CecchiLinux/arduino-guitar-trainer/README.md

# arduino-guitar-trainer

Progetto per il corso di Laboratorio di Making, anno 2017/2018. [Documentazione](./DOC.md).

L'Arduino-Guitar-Trainer è uno strumento hardware che aggiunge al classico metronomo alcune funzionalità pensate per il chitarrista principiante. Grazie alla trasposizione hardware del manico della chitarra, l'AGT guida il principiante nell'esecuzione dei classici esercizi di riscaldamento e di sviluppo dell'orecchio ritmico e della tecnica ritmica.

Lo strumento contiene i principali: accordi, giri armonici e scale. Il chitarrista potrà visualizzare questi elementi musicali nel manico di chitarra presente nello strumento, in modo da studiarli o ripassarli e poi decidere di suonarli azionando il meronomo. E' possibile selezionare bpm e numero di movimenti per battuta.
