CecchiLinux/arduino-guitar-trainer/imgs/05-fronte_pcb.jpg

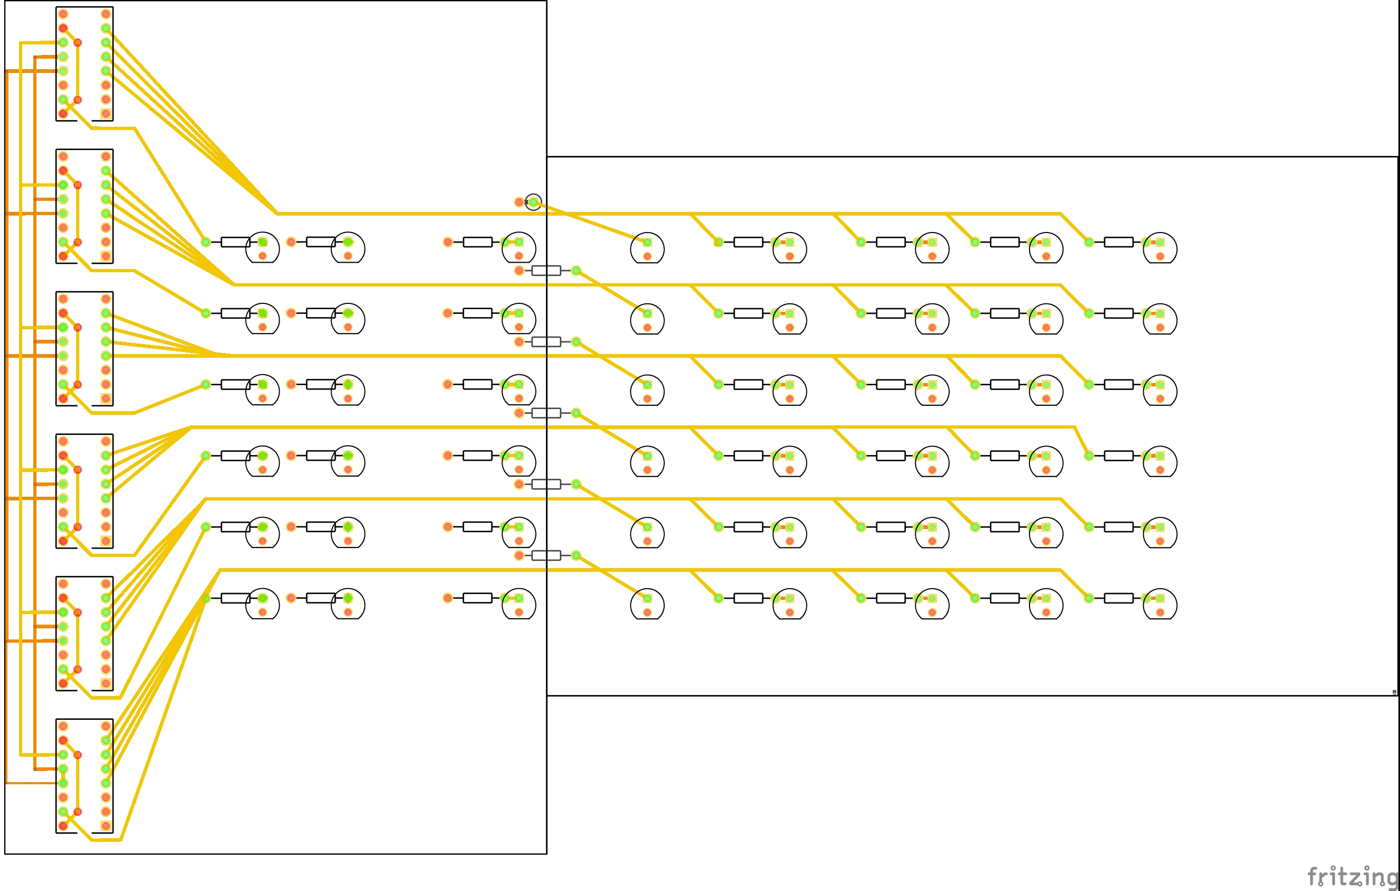
imgs/05-fronte_pcb.jpg
