CecchiLinux/arduino-guitar-trainer/imgs/05_pcb.jpg

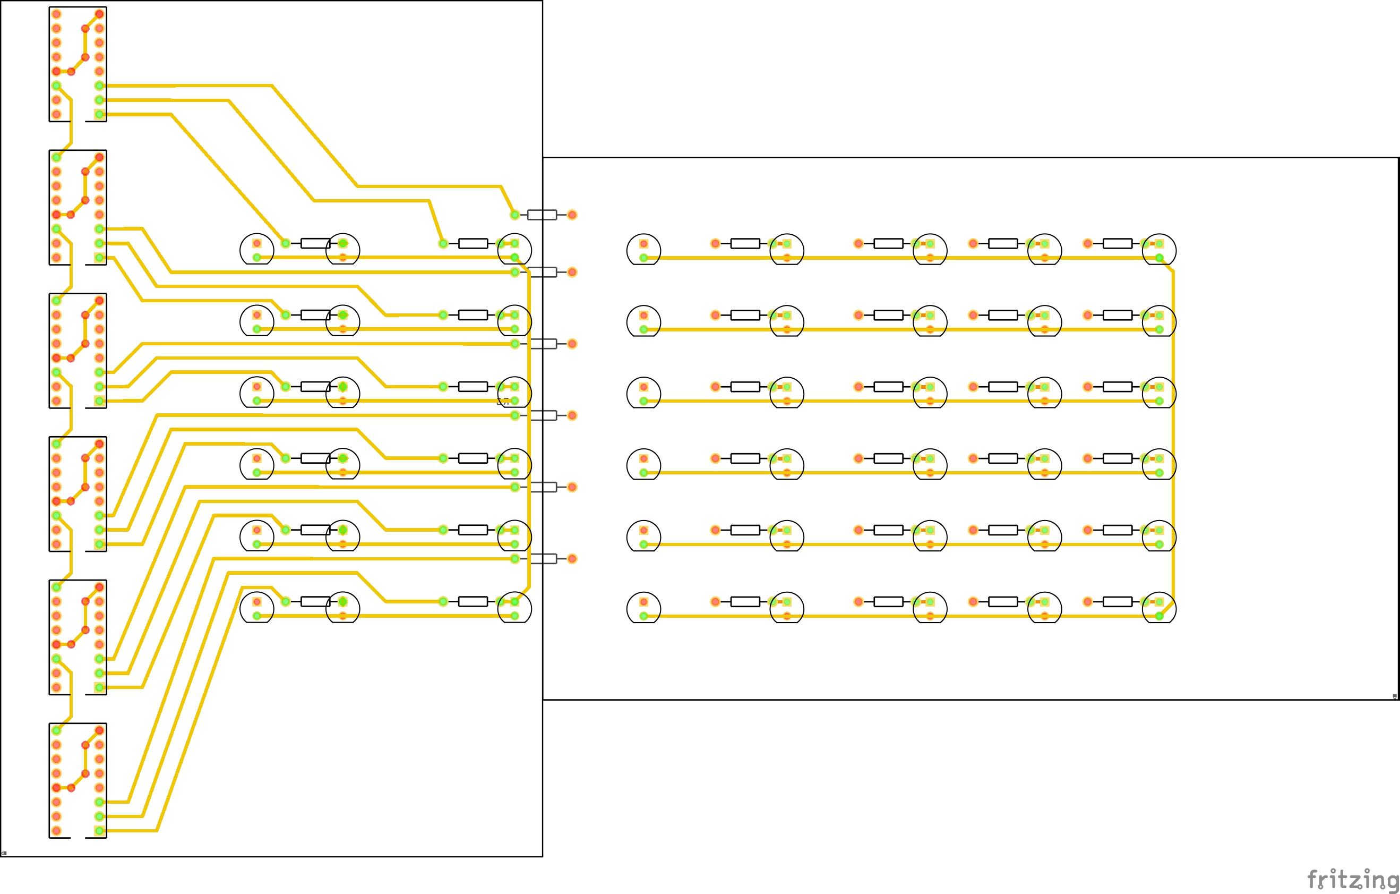
imgs/05_pcb.jpg
