CecchiLinux/arduino-guitar-trainer/imgs/neck.jpg

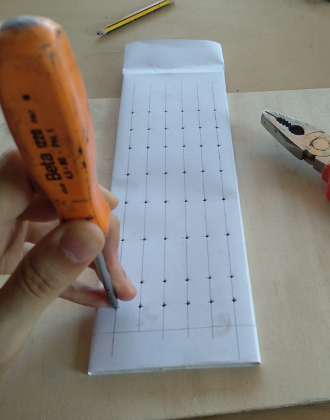
imgs/neck.jpg
