CecchiLinux/arduino-guitar-trainer/imgs/p2.jpg

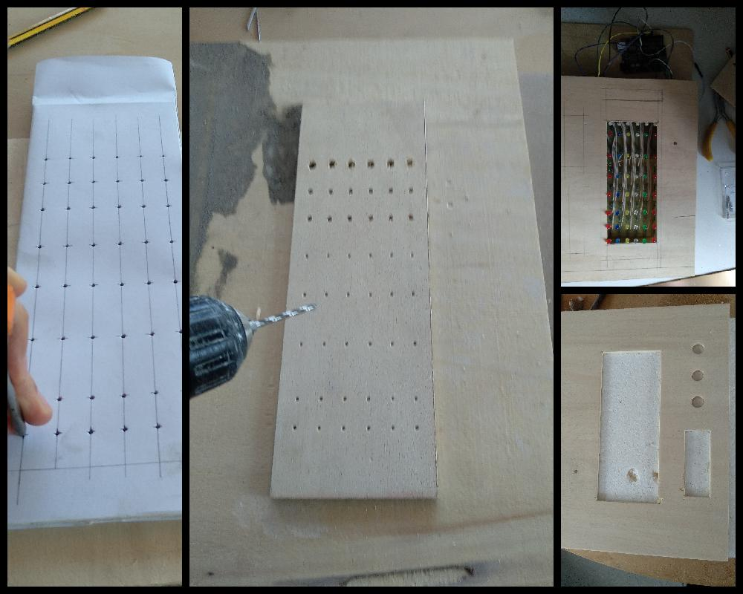
imgs/p2.jpg
