CecchiLinux/arduino-guitar-trainer/imgs/scatola.jpg

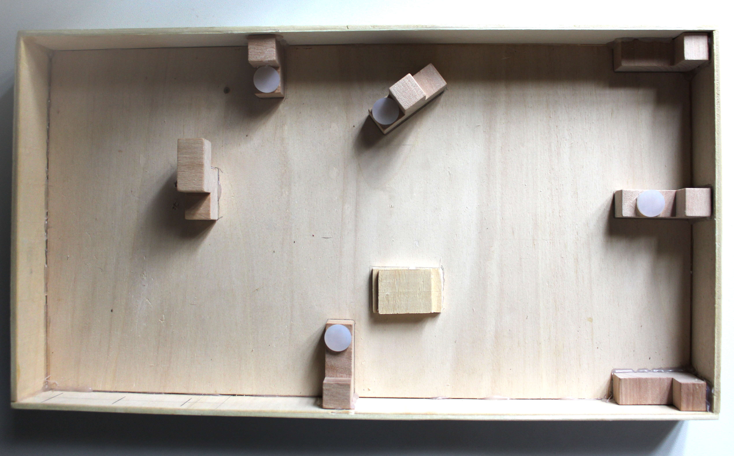
imgs/scatola.jpg
