CecchiLinux/arduino-guitar-trainer/imgs/StateMachine.png

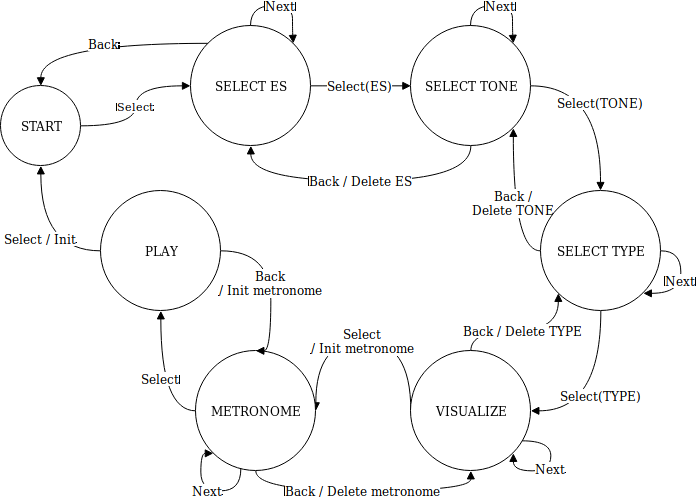
imgs/StateMachine.png
