CecchiLinux/arduino-guitar-trainer/arduinoCode/MetronomeImpl.h

/*
 * This file is part of Arduino-Guitar-Trainer.
 * 
 * Created by Enrico Ceccolini on 09/10/2018.
 * 
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
 * You should have received a copy of the GNU General Public License
 * along with this program.  If not, see <http://www.gnu.org/licenses/>.
 */

#ifndef __METRONOMEIMPL__
#define __METRONOMEIMPL__

#include "Arduino.h"
#include "Metronome.h"

#define STEP 20
#define DEFAULT_BPM 60
#define DEFAULT_BPM_C 4
#define MAX_BPM 220
#define MIN_BPM 20
#define MAX_CYCLE 8

class MetronomeImpl: public Metronome{
  private:
    short pin;
    short bpm;
    byte beatsPerCycle;
    byte currentBeatOnCycle = 0;
      
  public:
    MetronomeImpl(short pin);
    void init();
    bool tick();
    void setBeatsPCycle();
    void reset();
    void updateBPM();
    void updateBeatsPCycle();

    short getBPM();
    byte getBeatsPCycle();

};

#endif //__METRONOMEIMPL__
