CecchiLinux/arduino-guitar-trainer/arduinoCode/MetronomeImpl.cpp

/*
 * This file is part of Arduino-Guitar-Trainer.
 * 
 * Created by Enrico Ceccolini on 09/10/2018.
 * 
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
 * You should have received a copy of the GNU General Public License
 * along with this program.  If not, see <http://www.gnu.org/licenses/>.
 */

/**
    MetronomeImpl.cpp
    Purpose: Imlementation of a metronome

    @author Enrico Ceccolini
    @version 1.0
*/
#include "MetronomeImpl.h"

MetronomeImpl::MetronomeImpl(short pin)
{
  this->pin = pin;
  pinMode(this->pin, OUTPUT);
  this->bpm = DEFAULT_BPM;
  this->beatsPerCycle = DEFAULT_BPM_C;
}

void MetronomeImpl::init()
{
  TaskPeriod::init(60000 / this->bpm);  //60000 ms in a s
}

/**
    Play the metronome sound.
    The sound is different if the beat is the first of the cycle.

    @return True if the beat is the first on the cycle.
*/
bool MetronomeImpl::tick()
{
  this->currentBeatOnCycle = (this->currentBeatOnCycle+1)%this->beatsPerCycle;
  if(this->currentBeatOnCycle == 1){ //the first on the cycle
    tone(this->pin, 3000, 200);
    return true;
  }
  tone(this->pin, 2000, 200);
  return false;
}

/**
    Add a STEP at the metronome bpm period up to the maximum.
*/
void MetronomeImpl::updateBPM()
{
  this->bpm = (this->bpm+STEP)%(MAX_BPM+STEP);
  if(this->bpm == 0)
    this->bpm = MIN_BPM;
}

/**
    Add a beat per cycle up to the maximum.
*/
void MetronomeImpl::updateBeatsPCycle()
{
  this->beatsPerCycle = (this->beatsPerCycle+1)%(MAX_CYCLE+1);
  if(this->beatsPerCycle == 0)
    this->beatsPerCycle = 1;
}

short MetronomeImpl::getBPM()
{
  return this->bpm;
}

byte MetronomeImpl::getBeatsPCycle()
{
  return this->beatsPerCycle;
}


void MetronomeImpl::reset()
{
  this->currentBeatOnCycle = 0;
  this->bpm = DEFAULT_BPM;
  this->beatsPerCycle = DEFAULT_BPM_C;
}
